hpvdt/falcon_windspeed/README.md

# Windspeed System

System to determine the relative wind to the aircraft as a 3D vector using an array of differential pressure sensors.
