hpvdt/falcon_windspeed/hardware/sensor_array_atmega/sensor_array_atmega.kicad_pcb

## KiCad design hardware/sensor_array_atmega/sensor_array_atmega.kicad_pcb (2025-08-17)

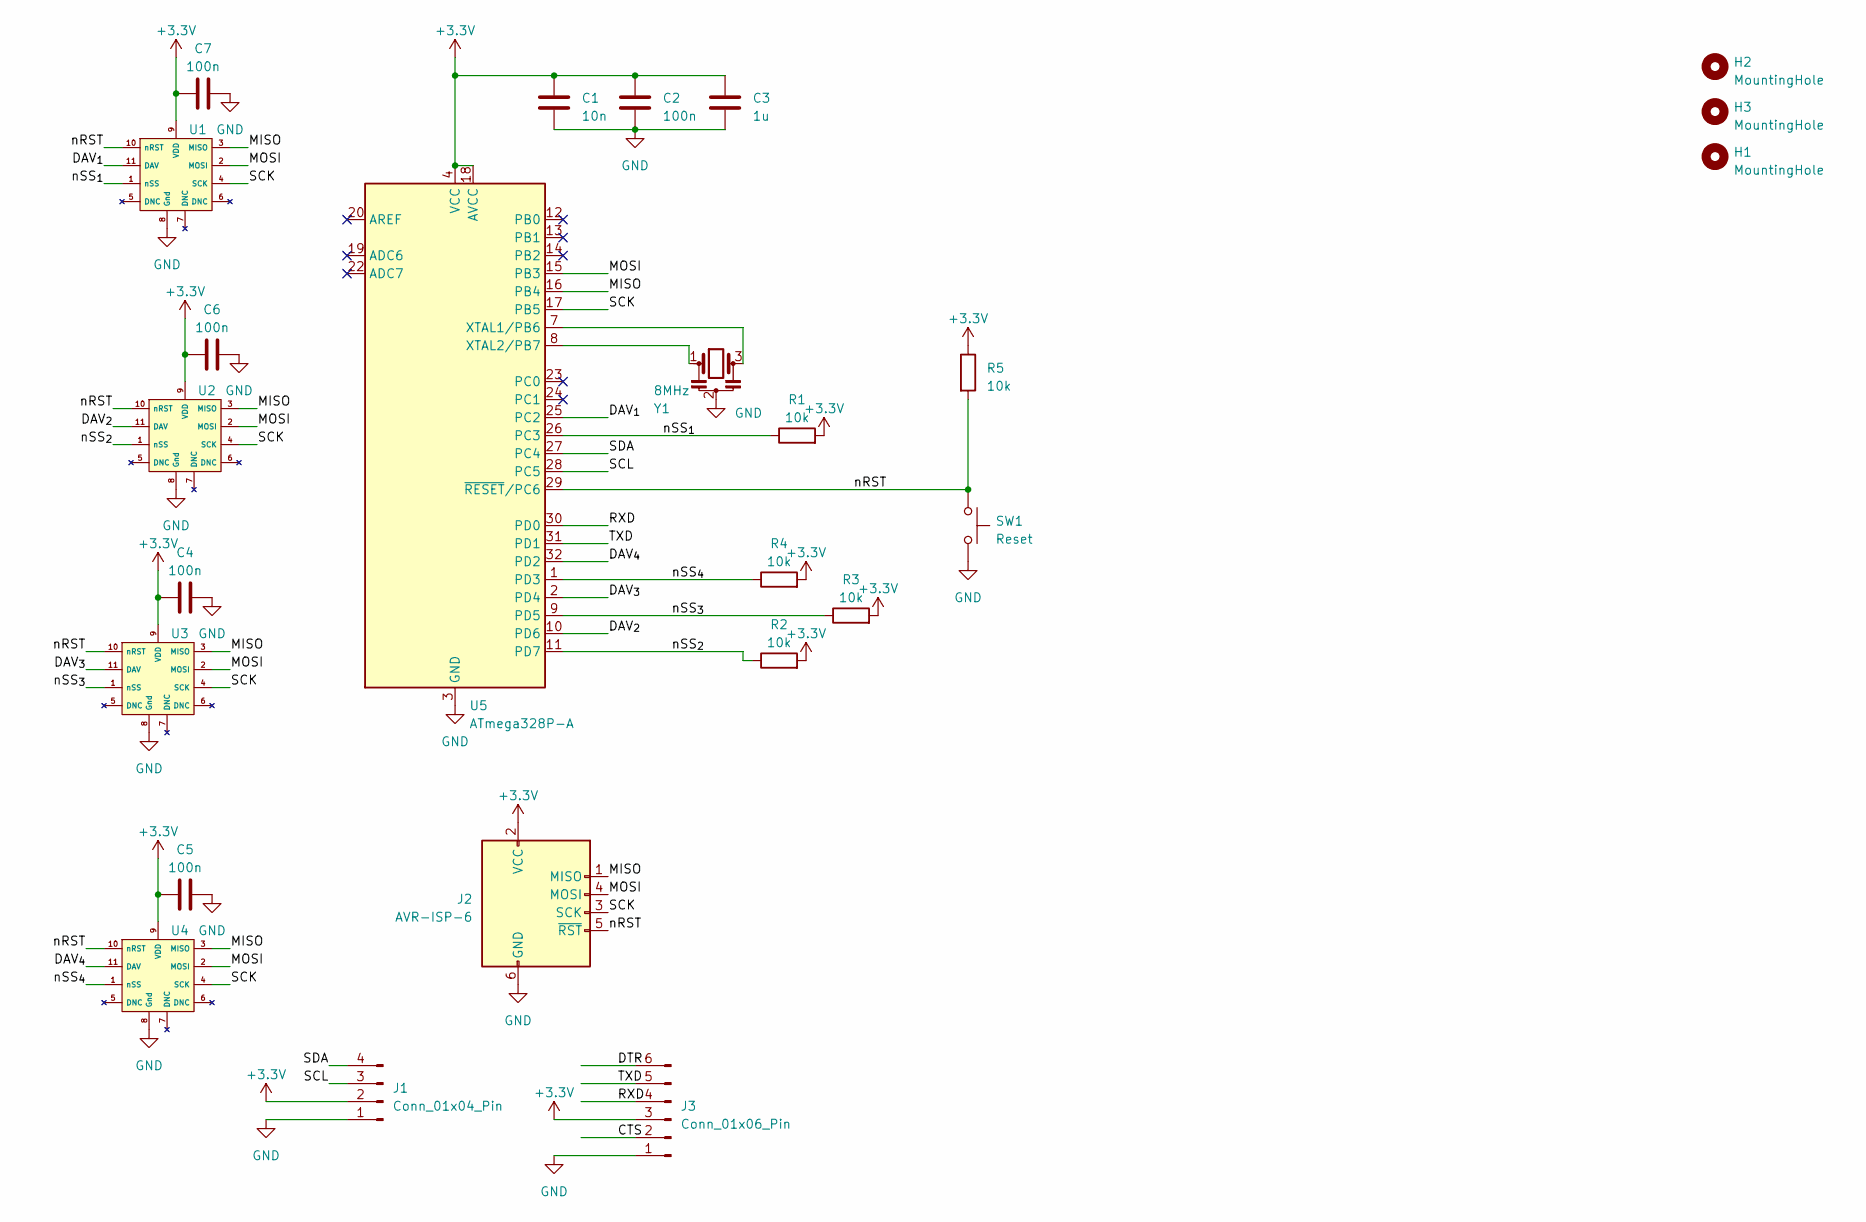
[picture p1: schematic sensor_array_atmega.kicad_sch, Presure Sensor Array]

Parts:
C1: 10n; C_0603_1608Metric
C2, C4, C5, C6, C7: 100n; C_0603_1608Metric
C3: 1u; C_0603_1608Metric
H1, H2, H3: MountingHole; MountingHole_3.2mm_M3
J1: Conn_01x04_Pin; PinHeader_1x04_P2.54mm_Vertical
J2: AVR-ISP-6; IDC-Header_2x03_P2.54mm_Vertical_SMD
J3: Conn_01x06_Pin; PinHeader_1x06_P2.54mm_Vertical
R1, R2, R3, R4, R5: 10k; R_0603_1608Metric
SW1: Reset; SW_SPST_SKQG_WithStem
U1, U2, U3, U4: HV120SM02C
U5: ATmega328P-A; TQFP-32_7x7mm_P0.8mm
Y1: 8MHz; Resonator_SMD-3Pin_7.2x3.0mm_HandSoldering

Connections:
+3.3V: C1.1, C2.1, C3.1, C4.1, C5.1, C6.1, C7.1, J1.2, J2.2 (VCC), J3.3, R1.2, R2.2, R3.2, R4.2, R5.1, U1.9 (VDD), U2.9 (VDD), U3.9 (VDD), U4.9 (VDD), U5.4 (VCC), U5.6 (VCC), U5.18 (AVCC)
/CTS: J3.2
/DAV_{1}: U1.11 (DAV), U5.25 (PC2)
/DAV_{2}: U2.11 (DAV), U5.10 (PD6)
/DAV_{3}: U3.11 (DAV), U5.2 (PD4)
/DAV_{4}: U4.11 (DAV), U5.32 (PD2)
/DTR: J3.6
/MISO: J2.1 (MISO), U1.3 (MISO), U2.3 (MISO), U3.3 (MISO), U4.3 (MISO), U5.16 (PB4)
/MOSI: J2.4 (MOSI), U1.2 (MOSI), U2.2 (MOSI), U3.2 (MOSI), U4.2 (MOSI), U5.15 (PB3)
/RXD: J3.4, U5.30 (PD0)
/SCK: J2.3 (SCK), U1.4 (SCK), U2.4 (SCK), U3.4 (SCK), U4.4 (SCK), U5.17 (PB5)
/SCL: J1.3, U5.28 (PC5)
/SDA: J1.4, U5.27 (PC4)
/TXD: J3.5, U5.31 (PD1)
/nRST: J2.5 (~RST), R5.2, SW1.1, U1.10 (nRST), U2.10 (nRST), U3.10 (nRST), U4.10 (nRST), U5.29 (~RESET/PC6)
/nSS_{1}: R1.1, U1.1 (nSS), U5.26 (PC3)
/nSS_{2}: R2.1, U2.1 (nSS), U5.11 (PD7)
/nSS_{3}: R3.1, U3.1 (nSS), U5.9 (PD5)
/nSS_{4}: R4.1, U4.1 (nSS), U5.1 (PD3)
GND: C1.2, C2.2, C3.2, C4.2, C5.2, C6.2, C7.2, J1.1, J2.6 (GND), J3.1, SW1.2, U1.8 (Gnd), U2.8 (Gnd), U3.8 (Gnd), U4.8 (Gnd), U5.3 (GND), U5.5 (GND), U5.21 (GND), Y1.2
unnamed: U5.7 (XTAL1/PB6), Y1.3
unnamed: U5.8 (XTAL2/PB7), Y1.1

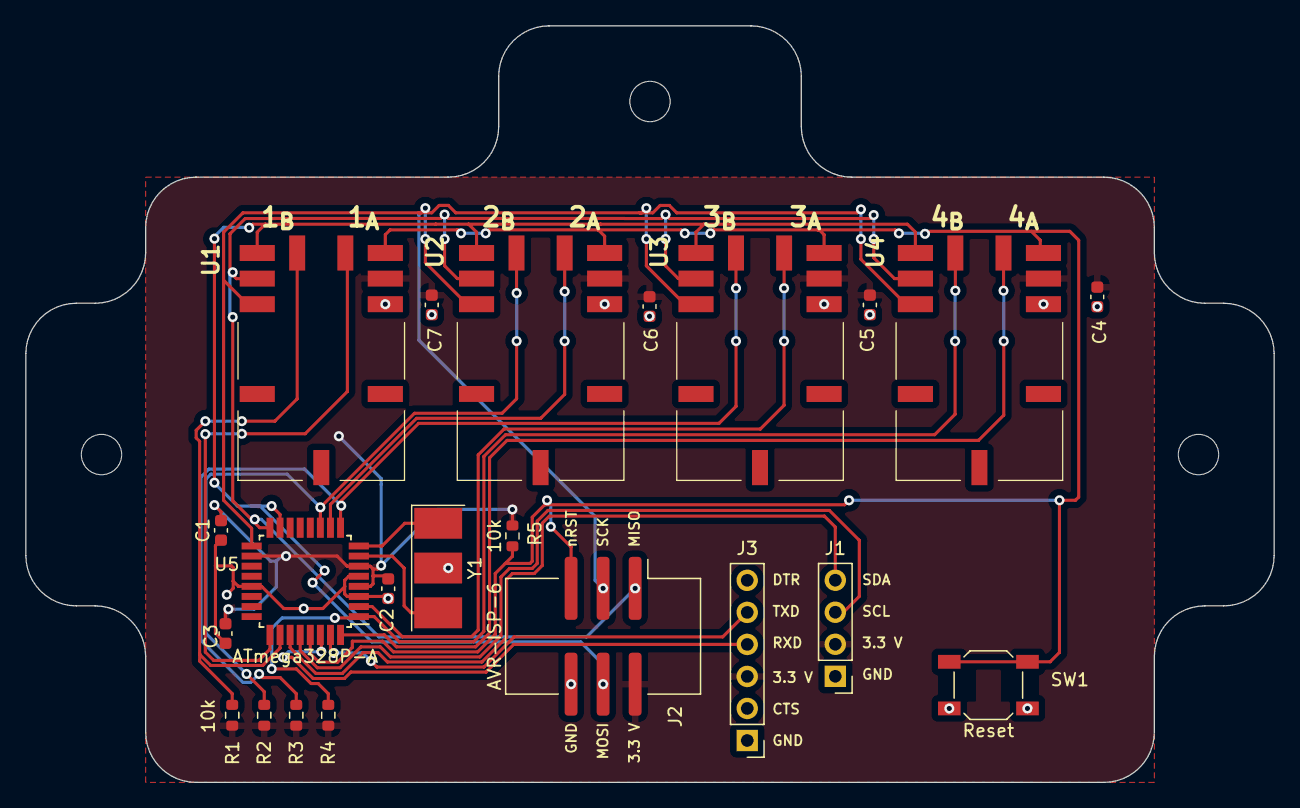
[picture p2: board sensor_array_atmega.kicad_pcb from above]

Board: 2 copper layers, 99.0 x 60.0 mm, 25 parts (0 on the bottom side), 20 nets.
