hpvdt/falcon_windspeed/hardware/sensor_array_rp2040/sensor_array_rp2040.kicad_pcb

## KiCad design hardware/sensor_array_rp2040/sensor_array_rp2040.kicad_pcb (2025-08-17)

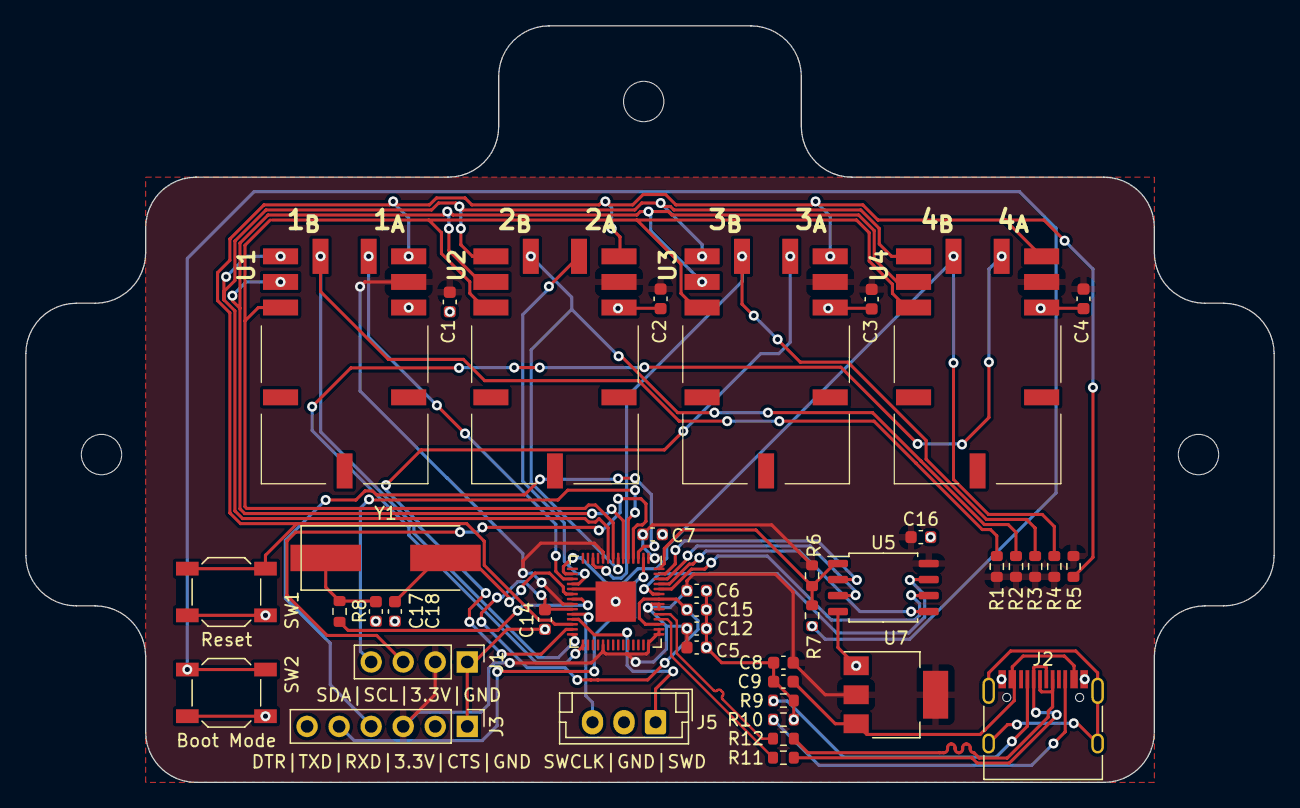
[picture p3: board sensor_array_rp2040.kicad_pcb from above]

Board: 2 copper layers, 99.0 x 60.0 mm, 44 parts (0 on the bottom side), 38 nets.

Parts:
C1, C2, C3, C4, C5, C6, C7, C14, C16: 100n; C_0603_1608Metric
C8, C9: 22u; C_0603_1608Metric
C12, C15: 1n; C_0603_1608Metric
C17, C18: 27p; C_0603_1608Metric
H1, H2, H3: MountingHole; MountingHole_3.2mm_M3
J1: Conn_01x04_Pin; PinHeader_1x04_P2.54mm_Vertical
J2: USB_C_Receptacle_USB2.0; USB_C_Receptacle_HRO_TYPE-C-31-M-12
J3: Conn_01x06_Pin; PinHeader_1x06_P2.54mm_Vertical
J5: Conn_01x03_Pin; JST_EH_B3B-EH-A_1x03_P2.50mm_Vertical
R1, R2, R3, R4, R5, R6: 10k; R_0603_1608Metric
R7, R8: 1k; R_0603_1608Metric
R9, R10: 5.1k; R_0603_1608Metric
R11, R12: 22; R_0603_1608Metric
SW1: Reset; SW_SPST_SKQG_WithStem
SW2: Boot Mode; SW_SPST_SKQG_WithStem
U1, U2, U3, U4: HV120SM02C
U5: W25Q128JVS; SOIC-8_5.23x5.23mm_P1.27mm
U6: RP2040; QFN-56-1EP_7x7mm_P0.4mm_EP3.2x3.2mm
U7: AZ1117-3.3; SOT-223-3_TabPin2
Y1: Crystal; Crystal_SMD_HC49-SD(ABLS-12.000MHZ-B4-T)

Connections:
+1V1: C14.1, C15.1, U6.23 (DVDD), U6.45 (VREG_VOUT), U6.50 (DVDD)
+3.3V: C1.1, C2.1, C3.1, C4.1, C5.1, C6.1, C7.1, C8.2, C12.1, C16.1, J1.2, J3.3, R1.2, R2.2, R3.2, R4.2, R5.1, R6.1, U1.9 (VDD), U2.9 (VDD), U3.9 (VDD), U4.9 (VDD), U5.8 (VCC), U6.1 (IOVDD), U6.10 (IOVDD), U6.22 (IOVDD), U6.33 (IOVDD), U6.42 (IOVDD), U6.43 (ADC_AVDD), U6.44 (VREG_IN), U6.48 (USB_VDD), U6.49 (IOVDD), U7.2 (VO)
+5V: C9.2, J2.A4 (VBUS), J2.A9 (VBUS), J2.B4 (VBUS), J2.B9 (VBUS), U7.3 (VI)
/D+: J2.A6 (D+), J2.B6 (D+), R12.1
/D-: J2.A7 (D-), J2.B7 (D-), R11.1
/DAV_{1}: U1.11 (DAV), U6.17 (GPIO14)
/DAV_{2}: U2.11 (DAV), U6.18 (GPIO15)
/DAV_{3}: U3.11 (DAV), U6.27 (GPIO16)
/DAV_{4}: U4.11 (DAV), U6.29 (GPIO18)
/MISO: U1.3 (MISO), U2.3 (MISO), U3.3 (MISO), U4.3 (MISO), U6.6 (GPIO4)
/MOSI: U1.2 (MOSI), U2.2 (MOSI), U3.2 (MOSI), U4.2 (MOSI), U6.9 (GPIO7)
/QSPI_SCLK: U5.6 (CLK), U6.52 (QSPI_SCLK)
/QSPI_SD0: U5.5 (DI(IO0)), U6.53 (QSPI_SD0)
/QSPI_SD1: U5.2 (DO(IO1)), U6.55 (QSPI_SD1)
/QSPI_SD2: U5.3 (IO2), U6.54 (QSPI_SD2)
/QSPI_SD3: U5.7 (IO3), U6.51 (QSPI_SD3)
/QSPI_SS: R6.2, R7.1, U5.1 (~CS), U6.56 (QSPI_SS)
/RXD: J3.4, U6.3 (GPIO1)
/SCK: U1.4 (SCK), U2.4 (SCK), U3.4 (SCK), U4.4 (SCK), U6.8 (GPIO6)
/SCL: J1.4, U6.5 (GPIO3)
/SDA: J1.3, U6.4 (GPIO2)
/SWCLK: J5.3, U6.24 (SWCLK)
/SWD: J5.1, U6.25 (SWD)
/TXD: J3.5, U6.2 (GPIO0)
/USB_BOOT: R7.2, SW2.2
/USB_D+: R12.2, U6.47 (USB_DP)
/USB_D-: R11.2, U6.46 (USB_DM)
/nRST: R5.2, SW1.2, U1.10 (nRST), U2.10 (nRST), U3.10 (nRST), U4.10 (nRST), U6.26 (RUN)
/nSS_{1}: R1.1, U1.1 (nSS), U6.28 (GPIO17)
/nSS_{2}: R2.1, U2.1 (nSS), U6.7 (GPIO5)
/nSS_{3}: R3.1, U3.1 (nSS), U6.12 (GPIO9)
/nSS_{4}: R4.1, U4.1 (nSS), U6.16 (GPIO13)
GND: C1.2, C2.2, C3.2, C4.2, C5.2, C6.2, C7.2, C8.1, C9.1, C12.2, C14.2, C15.2, C16.2, C17.1, C18.1, J1.1, J2.A1 (GND), J2.A12 (GND), J2.B1 (GND), J2.B12 (GND), J3.1, J5.2, R9.2, R10.2, SW1.1, SW2.1, U1.8 (GND), U2.8 (GND), U3.8 (GND), U4.8 (GND), U5.4 (GND), U6.19 (TESTEN), U6.57 (GND), U7.1 (GND)
unnamed: C17.2, R8.1, Y1.1
unnamed: J2.A5 (CC1), R9.1
unnamed: J2.B5 (CC2), R10.1
unnamed: C18.2, U6.20 (XIN), Y1.2
unnamed: R8.2, U6.21 (XOUT)
