hpvdt/falcon_windspeed/(threads)

Thread 4 (2024-08-12):

Add interpolation for wind vector calibration

savob, 2024-08-12:
Once this sensor is calibrated we may find that there is some corrective factor that needs to be applied to get the right wind speed and heading. This will likely take the form of some look-up table/grid so we need code to search a lookup table and apply the correction factors.

Thread 5 (2024-08-12):

Investigate sensor reading noise

savob, 2024-08-12:
Currently the sensors used (ND005) is providing values with significant noise even under static conditions. Perhaps adding a loop buffer to the readings for each sensor to average the last `n` readings can help address this issue.

savob, 2024-08-17:
Applying the notch filter and decreasing the bandwidth seems to have helped reduce noise a fair bit. It is now on the order of a few Pa which is a little over the noise floor specified in the data sheet, the rest may very well be due to the actual pressure reading changing.

The only real way forward I see is to change to the more sensitive [N110](https://superiorsensors.com/pressure-sensors/industrial/) sensors which should greatly improve the signal to noise ratio.
