hpvdt/falcon_windspeed/(commit log)

2023-11-30 pressure sensor code upload
    test?
2023-12-01 Update nd005.cpp
    Corrected MISO/MOSI pin allocations
2023-12-02 Test for all sensors
2024-01-17 Upload of code
    having issues with just about everything
    [main.cpp]
2024-01-17 Fixed up `PressureSensor` class
    - Removed unneeded `static` qualifier for `private` variables
    - Moved `pressureSPI` to be global instead of a private object. Makes more sense for all sensors to share this object and it fixes some issues.
    [main.cpp]
2024-02-09 fixed errors, added spi bus pointer
    [main.cpp]
2024-02-09 Fixed redundant things in previous merge
    [main.cpp]
2024-02-10 Tracking active pressure range in ND005 class
2024-02-23 add function to convert rawreading to pressureval
2024-04-11 new reading to pressure; pressure to speed funcs
2024-04-13 fixed nan/inf/0.0 problem (sqrt(-x)), very small #
    [main.cpp]
2024-07-01 Making pressure units explicit
2024-07-06 Merged pressure conversion functions
    Pressure conversion functions were originally seperate
    to the helper functions which made use of the values.
    This led to issues regarding unit mismatches. So now
    pressure readings have their units specified and
    wind speed function collects pressure directly.
2024-07-17 Baseline I2C communication functions working
2024-08-12 Moved to use `printf()` for cleaner code and message
2024-08-12 Added function to try and automatically zero sensors
2024-08-12 Fixed angular math for wind vector
    [main.cpp]
2024-08-16 Fixed raw reading
    Using `static` to store the last reading, resulted in it being shared
    between all objects of a class which was far from ideal. Moved it to be
    a private attribute of the class.
    [main.cpp]
2025-08-17 Reorganized and added hardware projects
    [sensor_array_atmega.kicad_pcb, sensor_array_atmega.kicad_sch, sensor_array_rp2040.kicad_pcb, sensor_array_rp2040.kicad_sch, sensor_break_out_rev_1.kicad_pcb, sensor_break_out_rev_1.kicad_sch]
